DevonHope/Open-E-Pin/hardware/case/out/back_cover.step

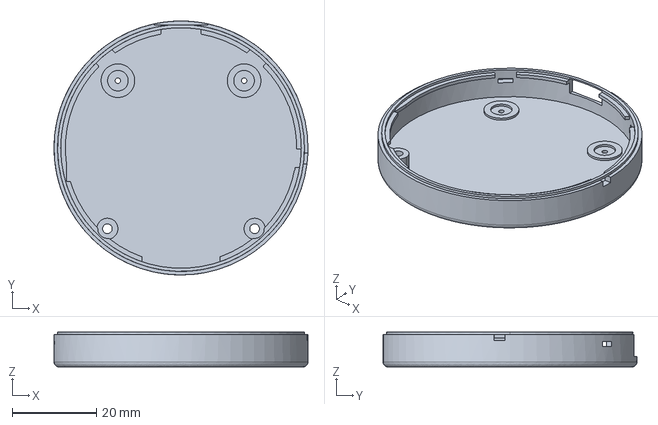
[picture p9: CAD file, 2026-11-13]
hardware/case/out/back_cover.step
60.4 x 60.4 x 8.30 mm
