DevonHope/Open-E-Pin/hardware/case/reference.step

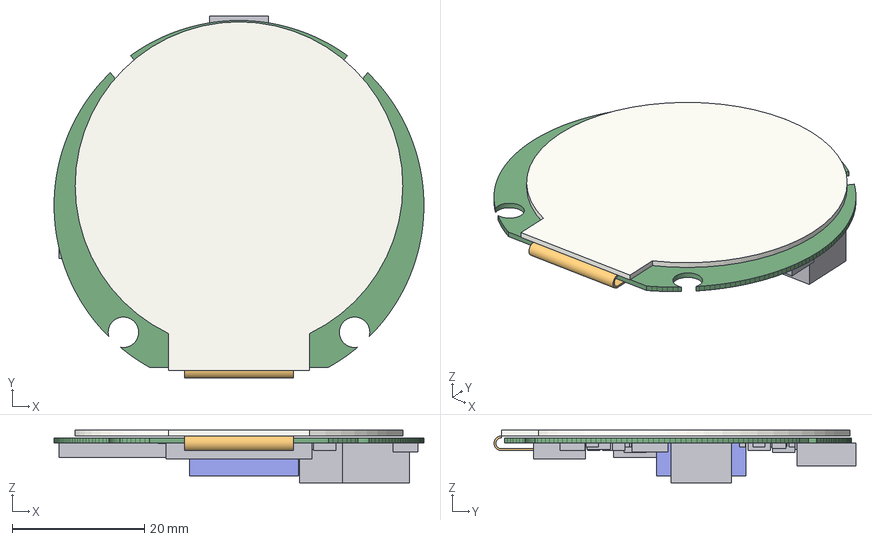
[picture p10: CAD file, 2026-11-13]
hardware/case/reference.step
56.0 x 54.8 x 7.95 mm
pcb
display
ribbon
part_J3
part_C12
part_U4
part_C7
part_J1
part_C2
part_C5
part_R6
part_Q1
part_U1
part_L1
part_TP3
part_C1
part_TP5
part_R14
part_R1
part_U2
part_Q2
part_R12
part_C24
part_TH1
part_R4
part_Q3
part_C13
part_C10
part_R7
part_D3
part_F1
part_J2
part_TP1
part_C3
part_C18
part_C23
part_R15
part_D2
part_TP2
part_R2
part_TP4
part_C11
part_C4
part_R8
part_R11
part_C22
part_U5
part_LED1
part_C17
part_C6
part_R5
part_C14
part_R3
part_C20
part_C21
part_C15
part_SW1
part_D1
part_C19
part_U3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
