DevonHope/Open-E-Pin/hardware/case/out/pin_retainer.step

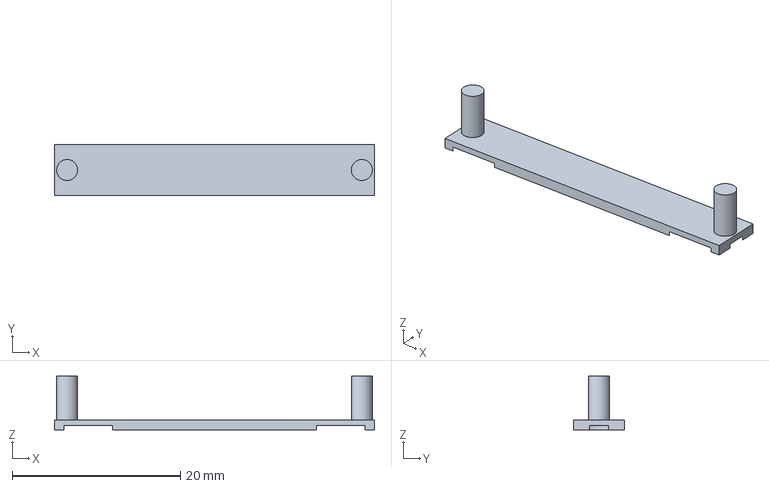
[picture p11: CAD file, 2026-11-13]
hardware/case/out/pin_retainer.step
38.0 x 6.00 x 6.40 mm
