DevonHope/Open-E-Pin/hardware/case/out/bezel.step

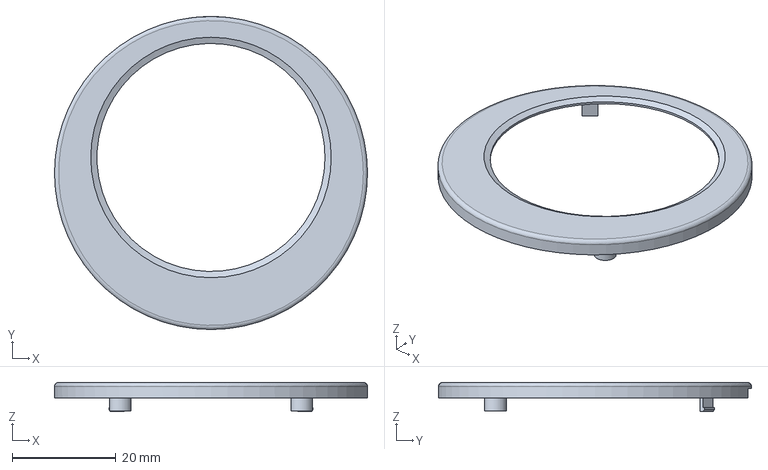
[picture p12: CAD file, 2026-11-13]
hardware/case/out/bezel.step
60.4 x 60.4 x 5.65 mm
