DevonHope/Open-E-Pin/hardware/case/out/button.step

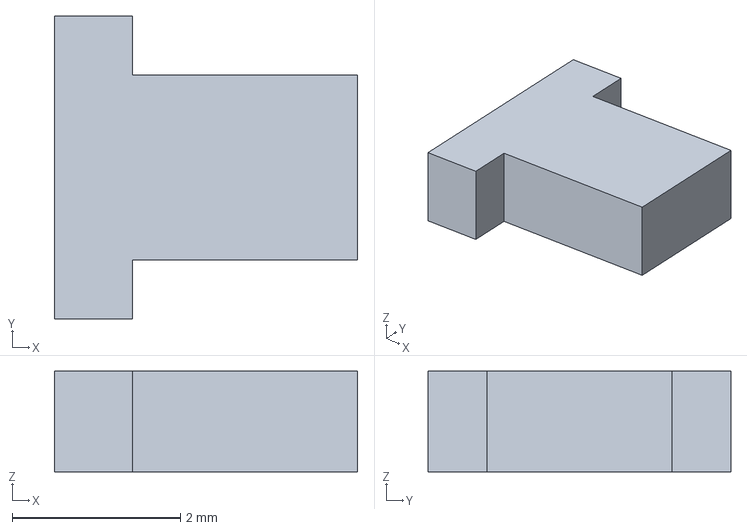
[picture p13: CAD file, 2026-11-13]
hardware/case/out/button.step
3.60 x 3.60 x 1.20 mm
