DevonHope/Open-E-Pin/(list of files, cad)

Other CAD files:
hardware/case/out/back_cover.stl
hardware/case/out/bezel.stl
hardware/case/out/button.stl
hardware/case/out/pin_retainer.stl
