DevonHope/Open-E-Pin/hardware/kicad/open-e-pin.kicad_pcb

## KiCad design hardware/kicad/open-e-pin.kicad_pcb (2026-11-13)

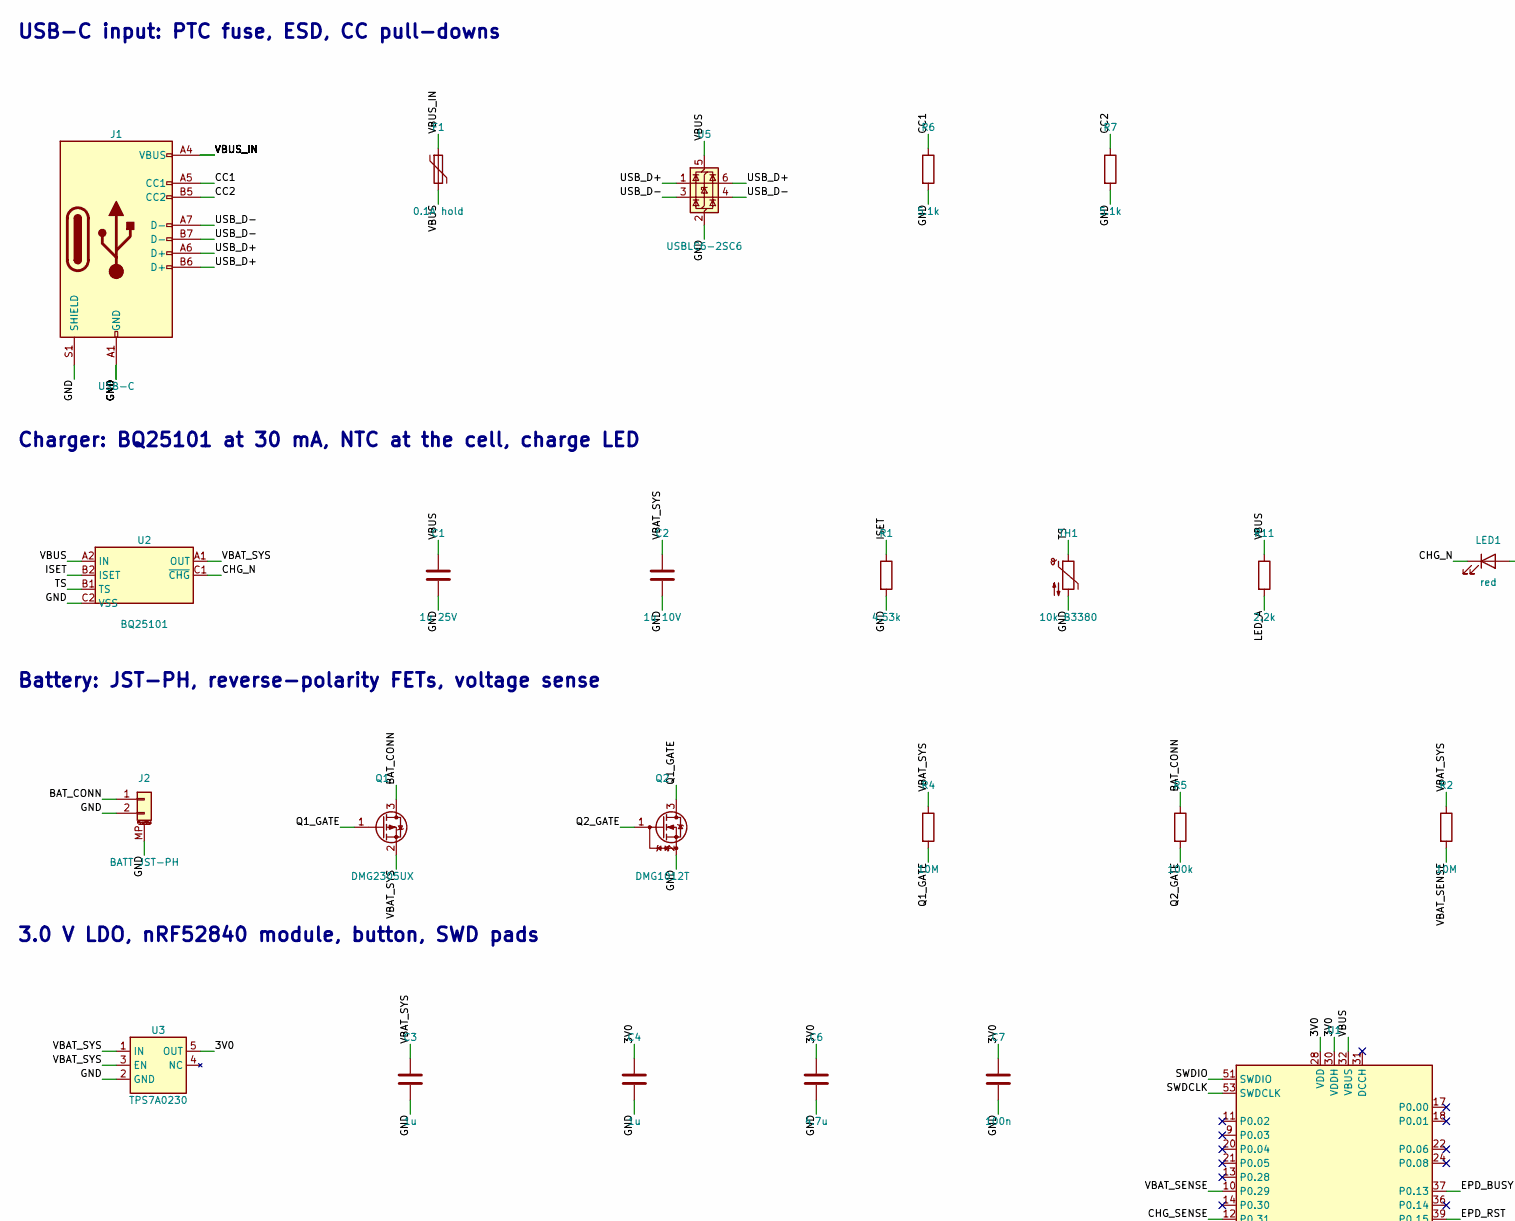
[picture p15: schematic open-e-pin.kicad_sch, Open E-Pin main board, part in row 1, column 1]

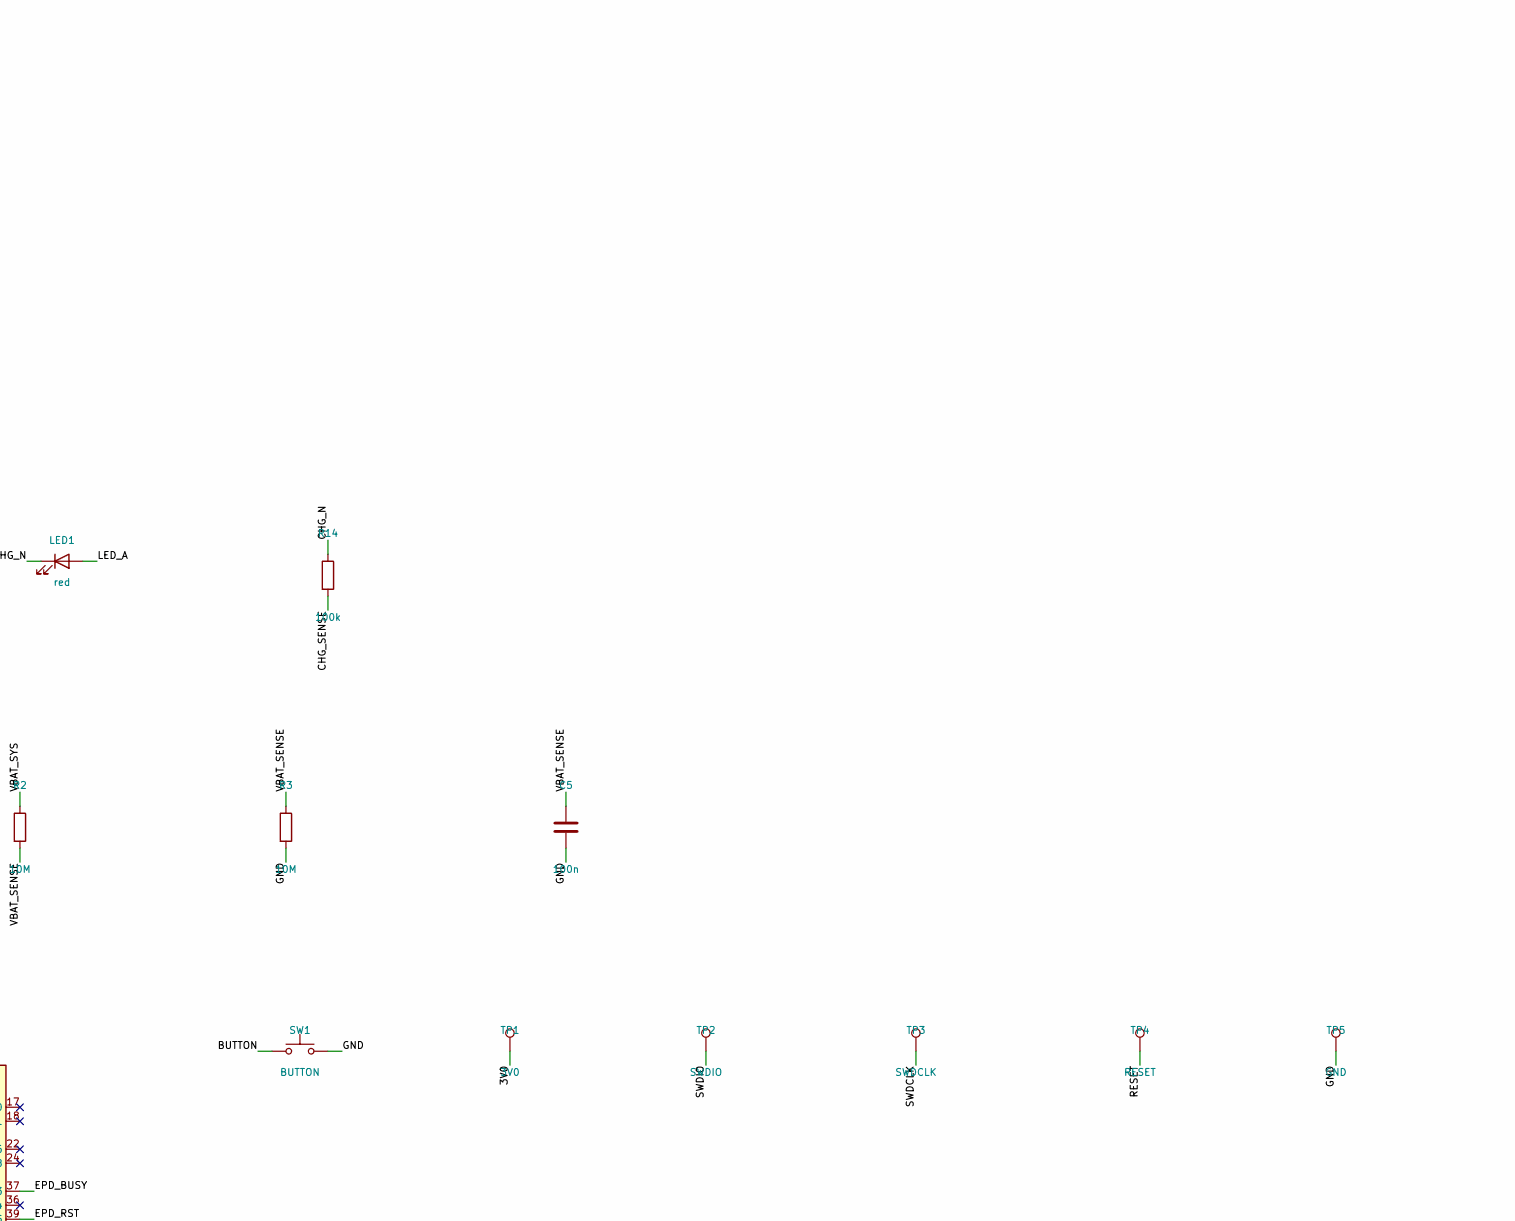
[picture p16: schematic open-e-pin.kicad_sch, Open E-Pin main board, part in row 1, column 2]

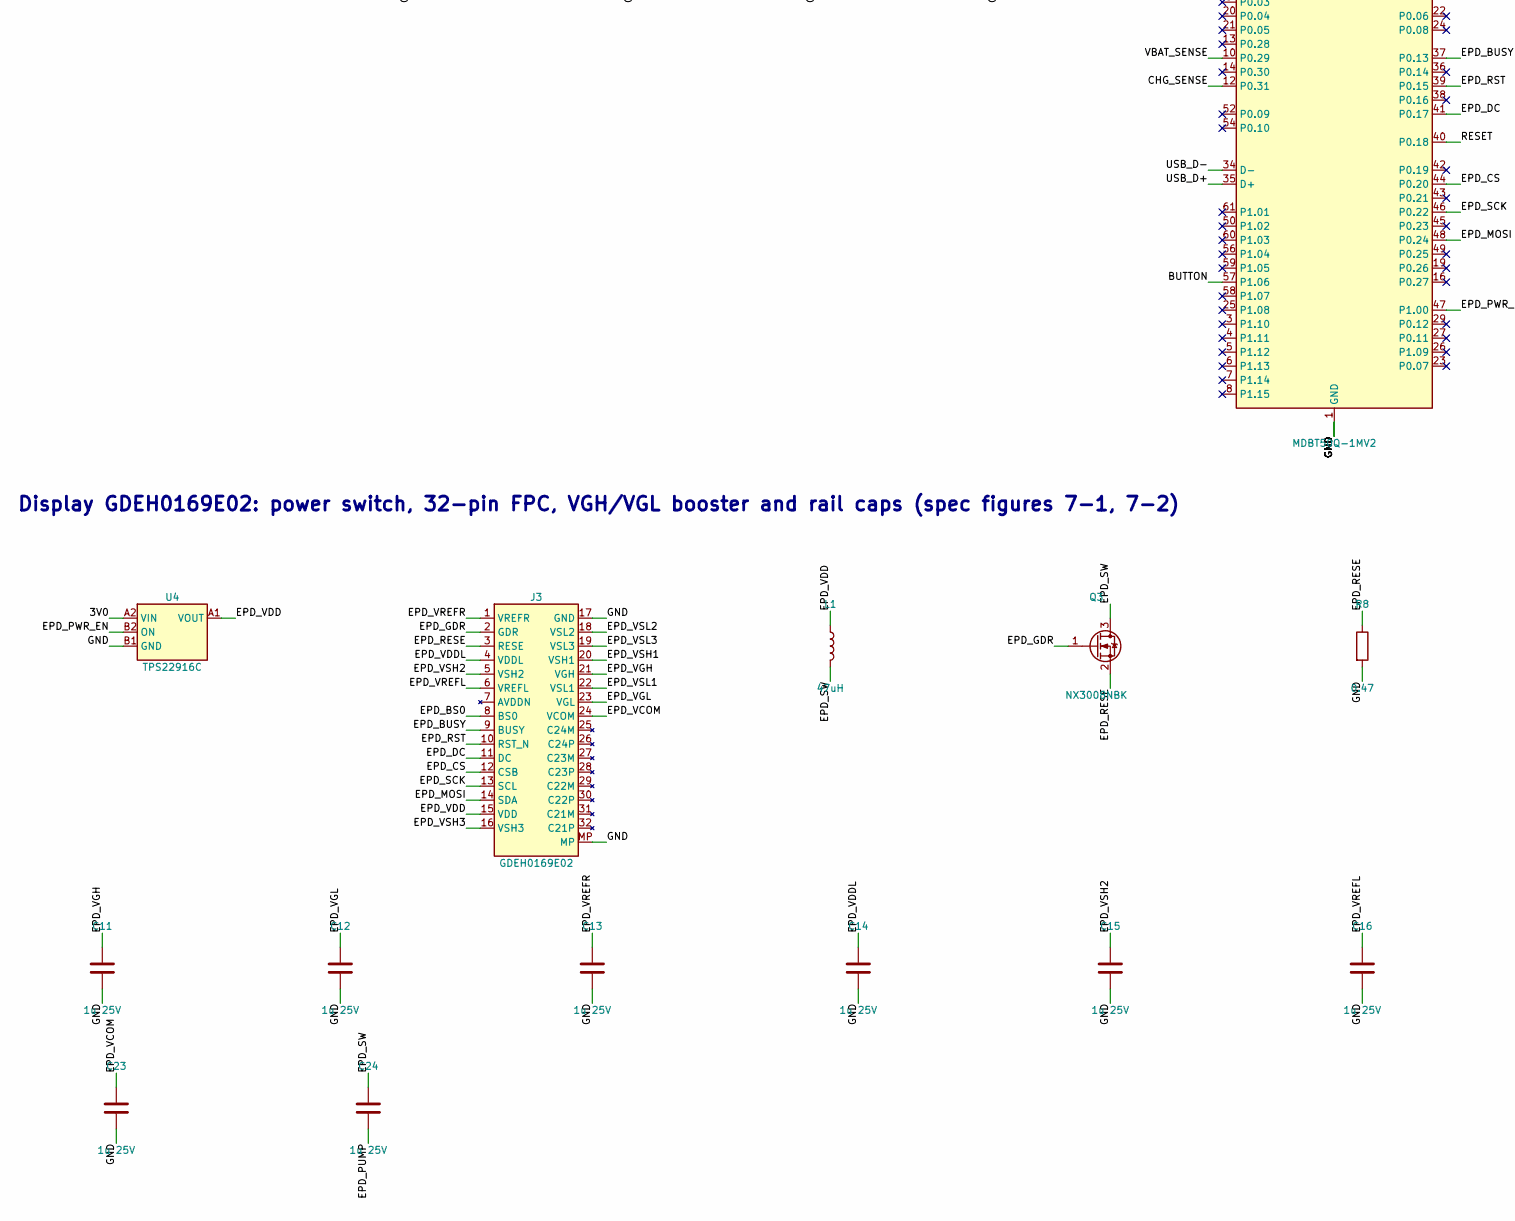
[picture p17: schematic open-e-pin.kicad_sch, Open E-Pin main board, part in row 2, column 1]

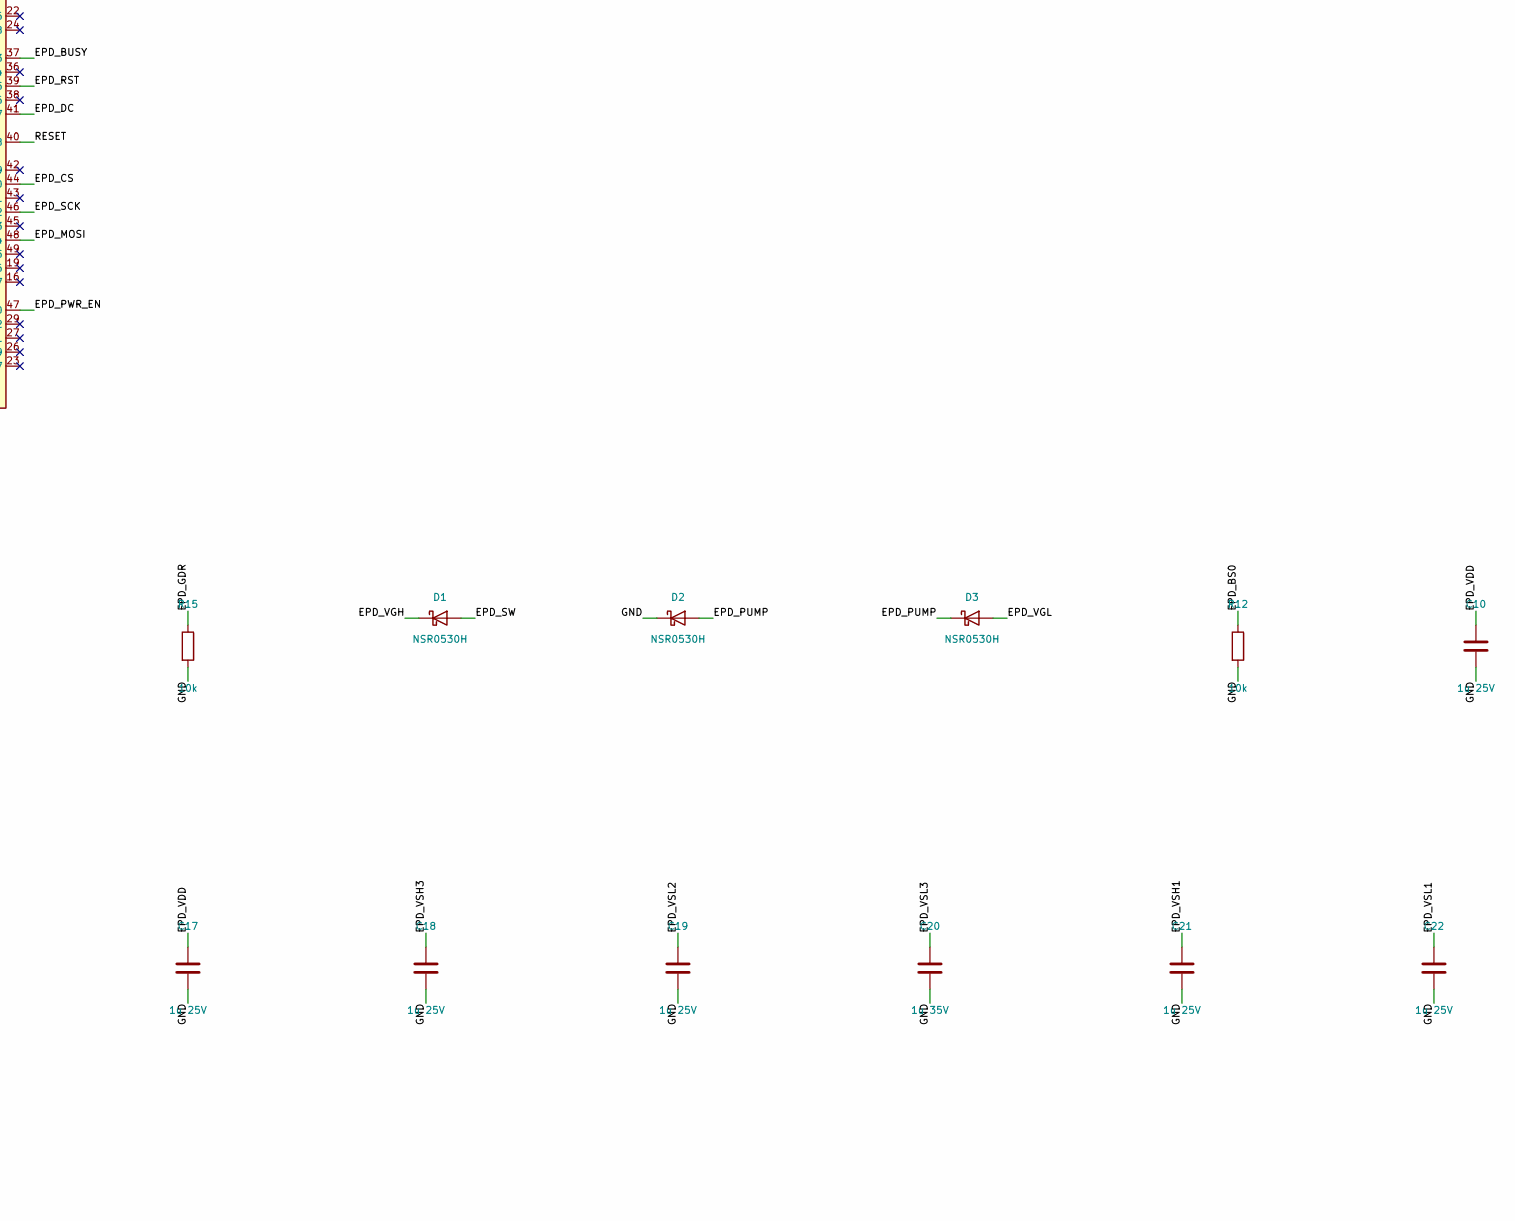
[picture p18: schematic open-e-pin.kicad_sch, Open E-Pin main board, part in row 2, column 2]

Parts:
C1, C10, C11, C12, C13, C14, C15, C16, C17, C18, C19, C21, C22, C23, C24: 1u 25V; C_0402_1005Metric
C2: 1u 10V; C_0402_1005Metric
C3, C4: 1u; C_0402_1005Metric
C5, C7: 100n; C_0402_1005Metric
C6: 4.7u; C_0402_1005Metric
C20: 1u 35V; C_0402_1005Metric
D1, D2, D3: NSR0530H; D_SOD-323
F1: 0.1A hold; Fuse_0603_1608Metric
J1: USB-C; USB_C_Receptacle_GCT_USB4105-xx-A_16P_TopMnt_Horizontal
J2: BATT JST-PH; JST_PH_S2B-PH-SM4-TB_1x02-1MP_P2.00mm_Horizontal
J3: GDEH0169E02; Hirose_FH12-32S-0.5SH_1x32-1MP_P0.50mm_Horizontal
L1: 47uH; L_Taiyo-Yuden_NR-30xx
LED1: red; LED_0402_1005Metric
Q1: DMG2305UX; SOT-23
Q2: DMG1012T; SOT-523
Q3: NX3008NBK; SOT-23
R1: 4.53k; R_0402_1005Metric
R2, R3, R4: 10M; R_0402_1005Metric
R5, R14: 100k; R_0402_1005Metric
R6, R7: 5.1k; R_0402_1005Metric
R8: 0.47; R_0603_1608Metric
R11: 2.2k; R_0402_1005Metric
R12, R15: 10k; R_0402_1005Metric
SW1: BUTTON; SW_SPST_EVQP7A
TH1: 10k B3380; R_0402_1005Metric
TP1: 3V0; TestPoint_Pad_1.0x1.0mm
TP2: SWDIO; TestPoint_Pad_1.0x1.0mm
TP3: SWDCLK; TestPoint_Pad_1.0x1.0mm
TP4: RESET; TestPoint_Pad_1.0x1.0mm
TP5: GND; TestPoint_Pad_1.0x1.0mm
U1: MDBT50Q-1MV2; Raytac_MDBT50Q
U2: BQ25101; Texas_YFP0006_DSBGA-6_0.9x1.6mm_P0.4mm
U3: TPS7A0230; SOT-23-5
U4: TPS22916C; Texas_YFP0004_DSBGA-4_0.78x0.78mm_P0.4mm
U5: USBLC6-2SC6; SOT-23-6

Connections:
3V0: C4.1, C6.1, C7.1, TP1.1, U1.28 (VDD), U1.30 (VDDH), U3.5 (OUT), U4.A2 (VIN)
BAT_CONN: J2.1, Q1.3 (D), R5.1
BUTTON: SW1.1, U1.57 (P1.06)
CC1: J1.A5 (CC1), R6.1
CC2: J1.B5 (CC2), R7.1
CHG_N: LED1.1 (K), R14.1, U2.C1 (~CHG)
CHG_SENSE: R14.2, U1.12 (P0.31)
EPD_BS0: J3.8 (BS0), R12.1
EPD_BUSY: J3.9 (BUSY), U1.37 (P0.13)
EPD_CS: J3.12 (CSB), U1.44 (P0.20)
EPD_DC: J3.11 (DC), U1.41 (P0.17)
EPD_GDR: J3.2 (GDR), Q3.1 (G), R15.1
EPD_MOSI: J3.14 (SDA), U1.48 (P0.24)
EPD_PUMP: C24.2, D2.2 (A), D3.1 (K)
EPD_PWR_EN: U1.47 (P1.00), U4.B2 (ON)
EPD_RESE: J3.3 (RESE), Q3.2 (S), R8.1
EPD_RST: J3.10 (RST_N), U1.39 (P0.15)
EPD_SCK: J3.13 (SCL), U1.46 (P0.22)
EPD_SW: C24.1, D1.2 (A), L1.2, Q3.3 (D)
EPD_VCOM: C23.1, J3.24 (VCOM)
EPD_VDD: C10.1, C17.1, J3.15 (VDD), L1.1, U4.A1 (VOUT)
EPD_VDDL: C14.1, J3.4 (VDDL)
EPD_VGH: C11.1, D1.1 (K), J3.21 (VGH)
EPD_VGL: C12.1, D3.2 (A), J3.23 (VGL)
EPD_VREFL: C16.1, J3.6 (VREFL)
EPD_VREFR: C13.1, J3.1 (VREFR)
EPD_VSH1: C21.1, J3.20 (VSH1)
EPD_VSH2: C15.1, J3.5 (VSH2)
EPD_VSH3: C18.1, J3.16 (VSH3)
EPD_VSL1: C22.1, J3.22 (VSL1)
EPD_VSL2: C19.1, J3.18 (VSL2)
EPD_VSL3: C20.1, J3.19 (VSL3)
GND: C1.2, C2.2, C3.2, C4.2, C5.2, C6.2, C7.2, C10.2, C11.2, C12.2, C13.2, C14.2, C15.2, C16.2, C17.2, C18.2, C19.2, C20.2, C21.2, C22.2, C23.2, D2.1 (K), J1.A1 (GND), J1.A12 (GND), J1.B1 (GND), J1.B12 (GND), J1.S1 (SHIELD), J2.2, J2.MP (MountPin), J3.17 (GND), J3.MP, Q2.2 (S), R1.2, R3.2, R6.2, R7.2, R8.2, R12.2, R15.2, SW1.2, TH1.2, TP5.1, U1.1 (GND), U1.2 (GND), U1.15 (GND), U1.33 (GND), U1.55 (GND), U2.C2 (VSS), U3.2 (GND), U4.B1 (GND), U5.2 (GND)
ISET: R1.1, U2.B2 (ISET)
LED_A: LED1.2 (A), R11.2
Q1_GATE: Q1.1 (G), Q2.3 (D), R4.2
Q2_GATE: Q2.1 (G), R5.2
RESET: TP4.1, U1.40 (P0.18)
SWDCLK: TP3.1, U1.53 (SWDCLK)
SWDIO: TP2.1, U1.51 (SWDIO)
TS: TH1.1, U2.B1 (TS)
USB_D+: J1.A6 (D+), J1.B6 (D+), U1.35 (D+), U5.1 (I/O1), U5.6 (I/O1)
USB_D-: J1.A7 (D-), J1.B7 (D-), U1.34 (D-), U5.3 (I/O2), U5.4 (I/O2)
VBAT_SENSE: C5.1, R2.2, R3.1, U1.10 (P0.29)
VBAT_SYS: C2.1, C3.1, Q1.2 (S), R2.1, R4.1, U2.A1 (OUT), U3.1 (IN), U3.3 (EN)
VBUS: C1.1, F1.2, R11.1, U1.32 (VBUS), U2.A2 (IN), U5.5 (VBUS)
VBUS_IN: F1.1, J1.A4 (VBUS), J1.A9 (VBUS), J1.B4 (VBUS), J1.B9 (VBUS)

Notes on the sheet:
USB-C input: PTC fuse, ESD, CC pull-downs
Charger: BQ25101 at 30 mA, NTC at the cell, charge LED
Battery: JST-PH, reverse-polarity FETs, voltage sense
3.0 V LDO, nRF52840 module, button, SWD pads
Display GDEH0169E02: power switch, 32-pin FPC, VGH/VGL booster and rail caps (spec figures 7-1, 7-2)

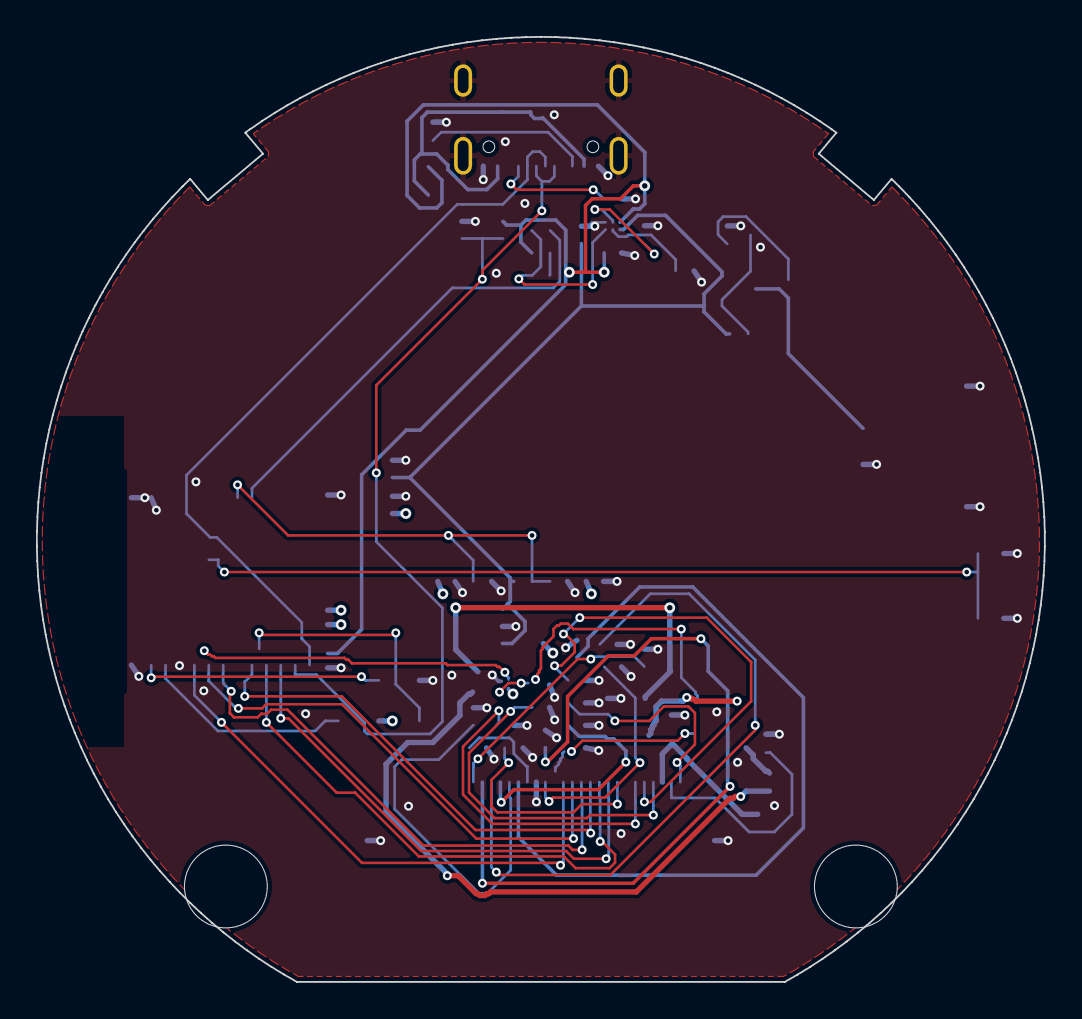
[picture p19: board open-e-pin.kicad_pcb from above]

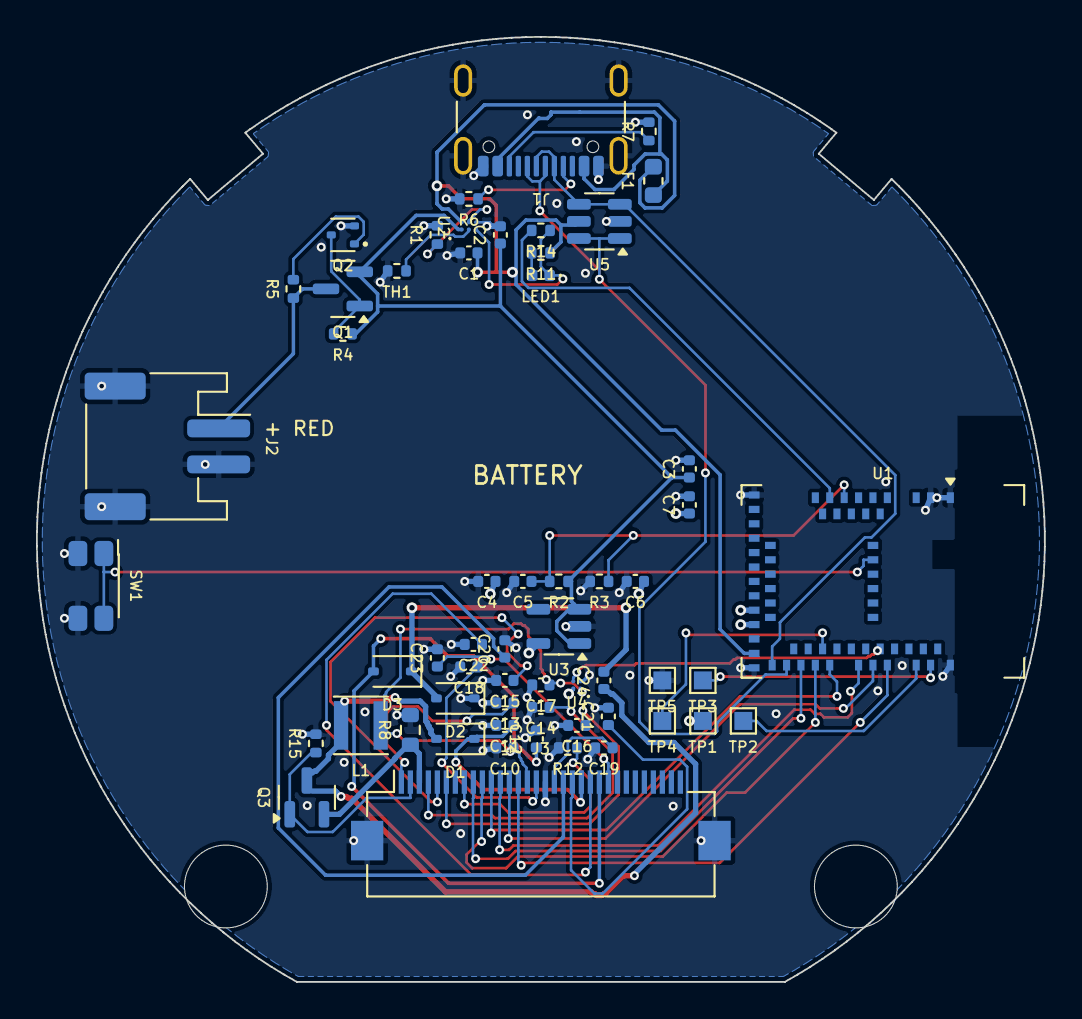
[picture p20: board open-e-pin.kicad_pcb from below]

Board: 4 copper layers, 56.0 x 52.5 mm, 60 parts (58 on the bottom side), 47 nets.

Other parts of the board:
H1, H2: M2; MountingHole_4.6mm_CaseBoss
