DevonHope/Open-E-Pin/(commit log)

2026-11-13 Expand README: app, firmware, case and renders
2026-11-13 Fix display controller name: IST7601 (JD7601), not IST7163
    The GDEH0169E02 spec's front page and the manufacturer's sample code both name the driver IC IST7601 / JD7601. IST7163 only heads the spec's reference part list.
    [design.py]
2026-11-13 Port the GDEH0169E02 driver to Good Display's EPD169_7601 sample
    Replace the placeholder init (borrowed from GDEP073E01-family panels) with
    the vendor's INIT_IST7601() sequence: FF/A5, D6/00, FF/E3, E9/01. Match
    the sample's double reset pulse (20 ms low, 10 ms high, twice), the BUSY
    wait after DTM1, the 10 ms settle before BUSY polling, 2 MHz SPI and a
    120 s BUSY timeout. Colour codes and BUSY polarity (low = busy) already
    matched the sample; update comments and READMEs, and rename the
    controller to IST7601 / JD7601 in the firmware.
    [epd.c, epd.h, epd_cmds.h]
2026-11-13 Strip embedded metadata from PCB render PNGs
2026-11-13 Case: captive tie tack posts with a printed retainer
    Replace the two outside pad pockets with captive posts. Each 0.045 in
    (1.15 mm) x 1/2 in flat-head tie tack post goes out through a 1.3 mm hole
    in the back plate, with its 4.7 mm head flush in a 4.9 mm recess on the
    inside, raised on an 8 mm pad so 1.2 mm of floor stays under the head.
    A printed retainer bar (new part) fits over both pads, presses the heads
    down and is held by two stand-offs that end 0.1 mm from the board.
    Posts move from Y +8 to Y +16 to clear J2 and the JST plug, which leave
    only 0.5 mm above the back plate at Y +8. The case stays 10.75 mm thick.
    The post position and sizes are design parameters (PIN_Y and friends).
    In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
    [assembly.step, back_cover.step, back_cover.stl, pin_retainer.step, pin_retainer.stl]
2026-11-13 Firmware: follow-up checks against the vendor EPD169_7601 sample
